devtank-ltd/prevail-ny_ventilator_interface_board/README.md

# prevail-ny_ventilator_interface_board
Interface board for PREVAIL-NY emergency ventilator
