devtank-ltd/prevail-ny_ventilator_interface_board/Ventilator_Interface_Board_RevA_BOM.xlsx

Title | PREVAIL-NY Emergency Ventilator Interface Board
Revision | A
Date | 2020-04-20
Generated | Tue 21 Apr 2020 09:53:51 BST
Company
Comment 1
Comment 2
Comment 3
Comment 4
Total Parts | 59
Total Unique Parts | 19
Ref | Qty | Value | Footprint | Manufacturer | Manufacturer Part Number | Supplier | Supplier Part number
C2 C3 C4 C5 C6 | 5 | 100nF | Capacitor_SMD:C_0603_1608Metric | Kemet | C0603C104M4RACTU | Digikey | 399-1099-1-ND
C1 C7 | 2 | 1uF | Capacitor_SMD:C_0603_1608Metric | Yageo | CC0603KRX7R7BB105 | Digikey | 311-1446-1-ND
C8 | 1 | 470pF | Capacitor_SMD:C_0603_1608Metric | Murata | GRM0335C1E471JA01D | Digikey | 490-16370-1-ND
C9 | 1 | DNF | Capacitor_SMD:C_0603_1608Metric
J1 J2 J3 J4 | 4 | Conn_01x08 | Ventilator:PhoenixContact_PTSA_1 | Phoenix Contact | 1985250 | Digikey | 277-1628-ND
P1 | 1 | Power | Socket_Arduino_Uno:Socket_Strip_Arduino_1x08 | Adafruit Industries | 85 | Digikey | 1528-1074-ND
P2 | 1 | Analog | Socket_Arduino_Uno:Socket_Strip_Arduino_1x06 | Adafruit Industries | 85 | Digikey | 1528-1074-ND | Only one kit required per board
P5 P6 P7 P8 | 4 | CONN_01X01 | Socket_Arduino_Uno:Arduino_1pin
P4 | 1 | Digital | Socket_Arduino_Uno:Socket_Strip_Arduino_1x08 | Adafruit Industries | 85 | Digikey | 1528-1074-ND
P3 | 1 | Digital | Socket_Arduino_Uno:Socket_Strip_Arduino_1x10 | Adafruit Industries | 85 | Digikey | 1528-1074-ND
R5 R4 R6 | 3 | 470R | Resistor_SMD:R_0603_1608Metric | Yageo | RC0603FR-07470RL | Digikey | 311-470HRCT-ND
R8 R10 R1 | 3 | 330R | Resistor_SMD:R_0603_1608Metric | Yageo | RC0603FR-07330RL | Digikey | 311-330HRCT-ND
R2 R9 R11 | 3 | 10K | Resistor_SMD:R_0603_1608Metric | Yageo | RC0603FR-0710KL | Digikey | 311-10.0KHRCT-ND
R3 R12 R13 | 3 | DNF | Resistor_SMD:R_0603_1608Metric
R7 R14 | 2 | 0R | Resistor_SMD:R_0603_1608Metric | Yageo | RC0603JR-070RL | Digikey | 311-0.0GRCT-ND
SW1 | 1 | SW_Push | Button_Switch_SMD:SW_SPST_B3U-1000P | Omron | B3U-1000P | Digikey | SW1020CT-ND
TP7 TP1 TP2 TP3 TP4 TP5 TP6 TP8 TP9 TP10 TP11 TP12 TP13 TP14 TP15 TP16 TP17 TP18 TP19 TP20 TP21 | 21 | TestPoint | TestPoint:TestPoint_THTPad_D1.0mm_Drill0.5mm
U1 | 1 | MP3V5004GP | Ventilator:SOP_16.8x7.62mm_P2.54mm | NXP | MP35004GP | Digikey | MP3V5004GP-ND
U2 | 1 | PSI-G-XX-MINI | DNF
Green | Can use equivalent/better
Black | Do not replace/substitute
DNP/DNF | do not populate / do not fit
