devtank-ltd/prevail-ny_ventilator_interface_board/Ventilator_Interface_Board_RevA.pdf

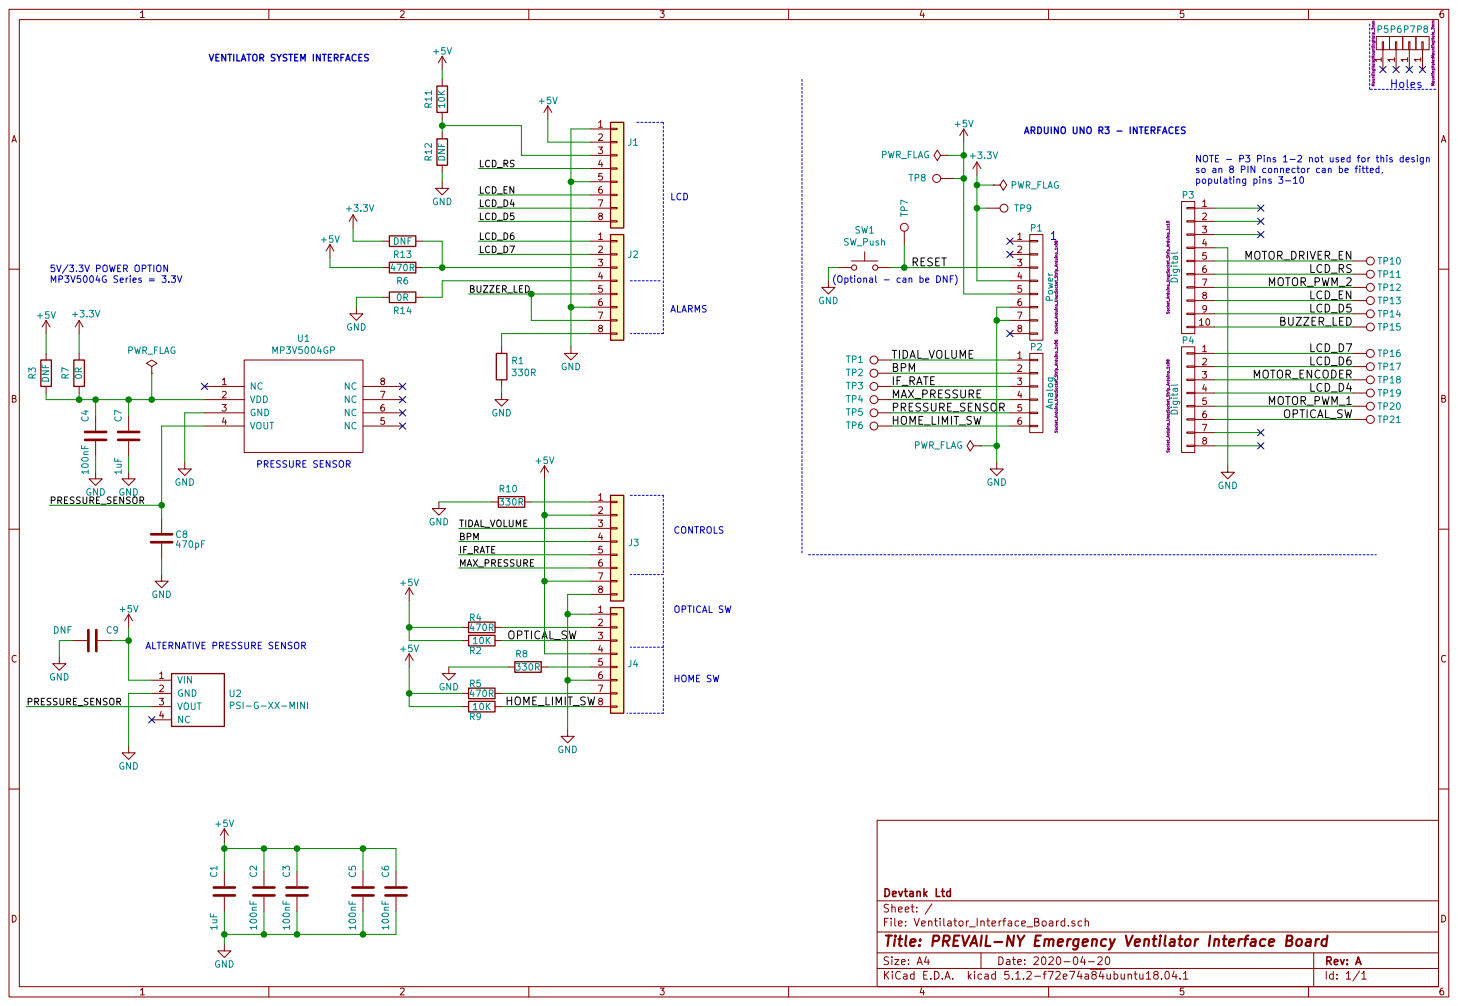
[picture p1: page 1]

IF_RATE | 3

File: Ventilator_Interface_Board.sch Sheet: / Devtank Ltd

Id: 1/1 Title: PREVAIL-NY Emergency Ventilator Interface Board
