devtank-ltd/prevail-ny_ventilator_interface_board/Ventilator_Interface_Board.kicad_pcb

## KiCad design Ventilator_Interface_Board.kicad_pcb (2020-04-20)

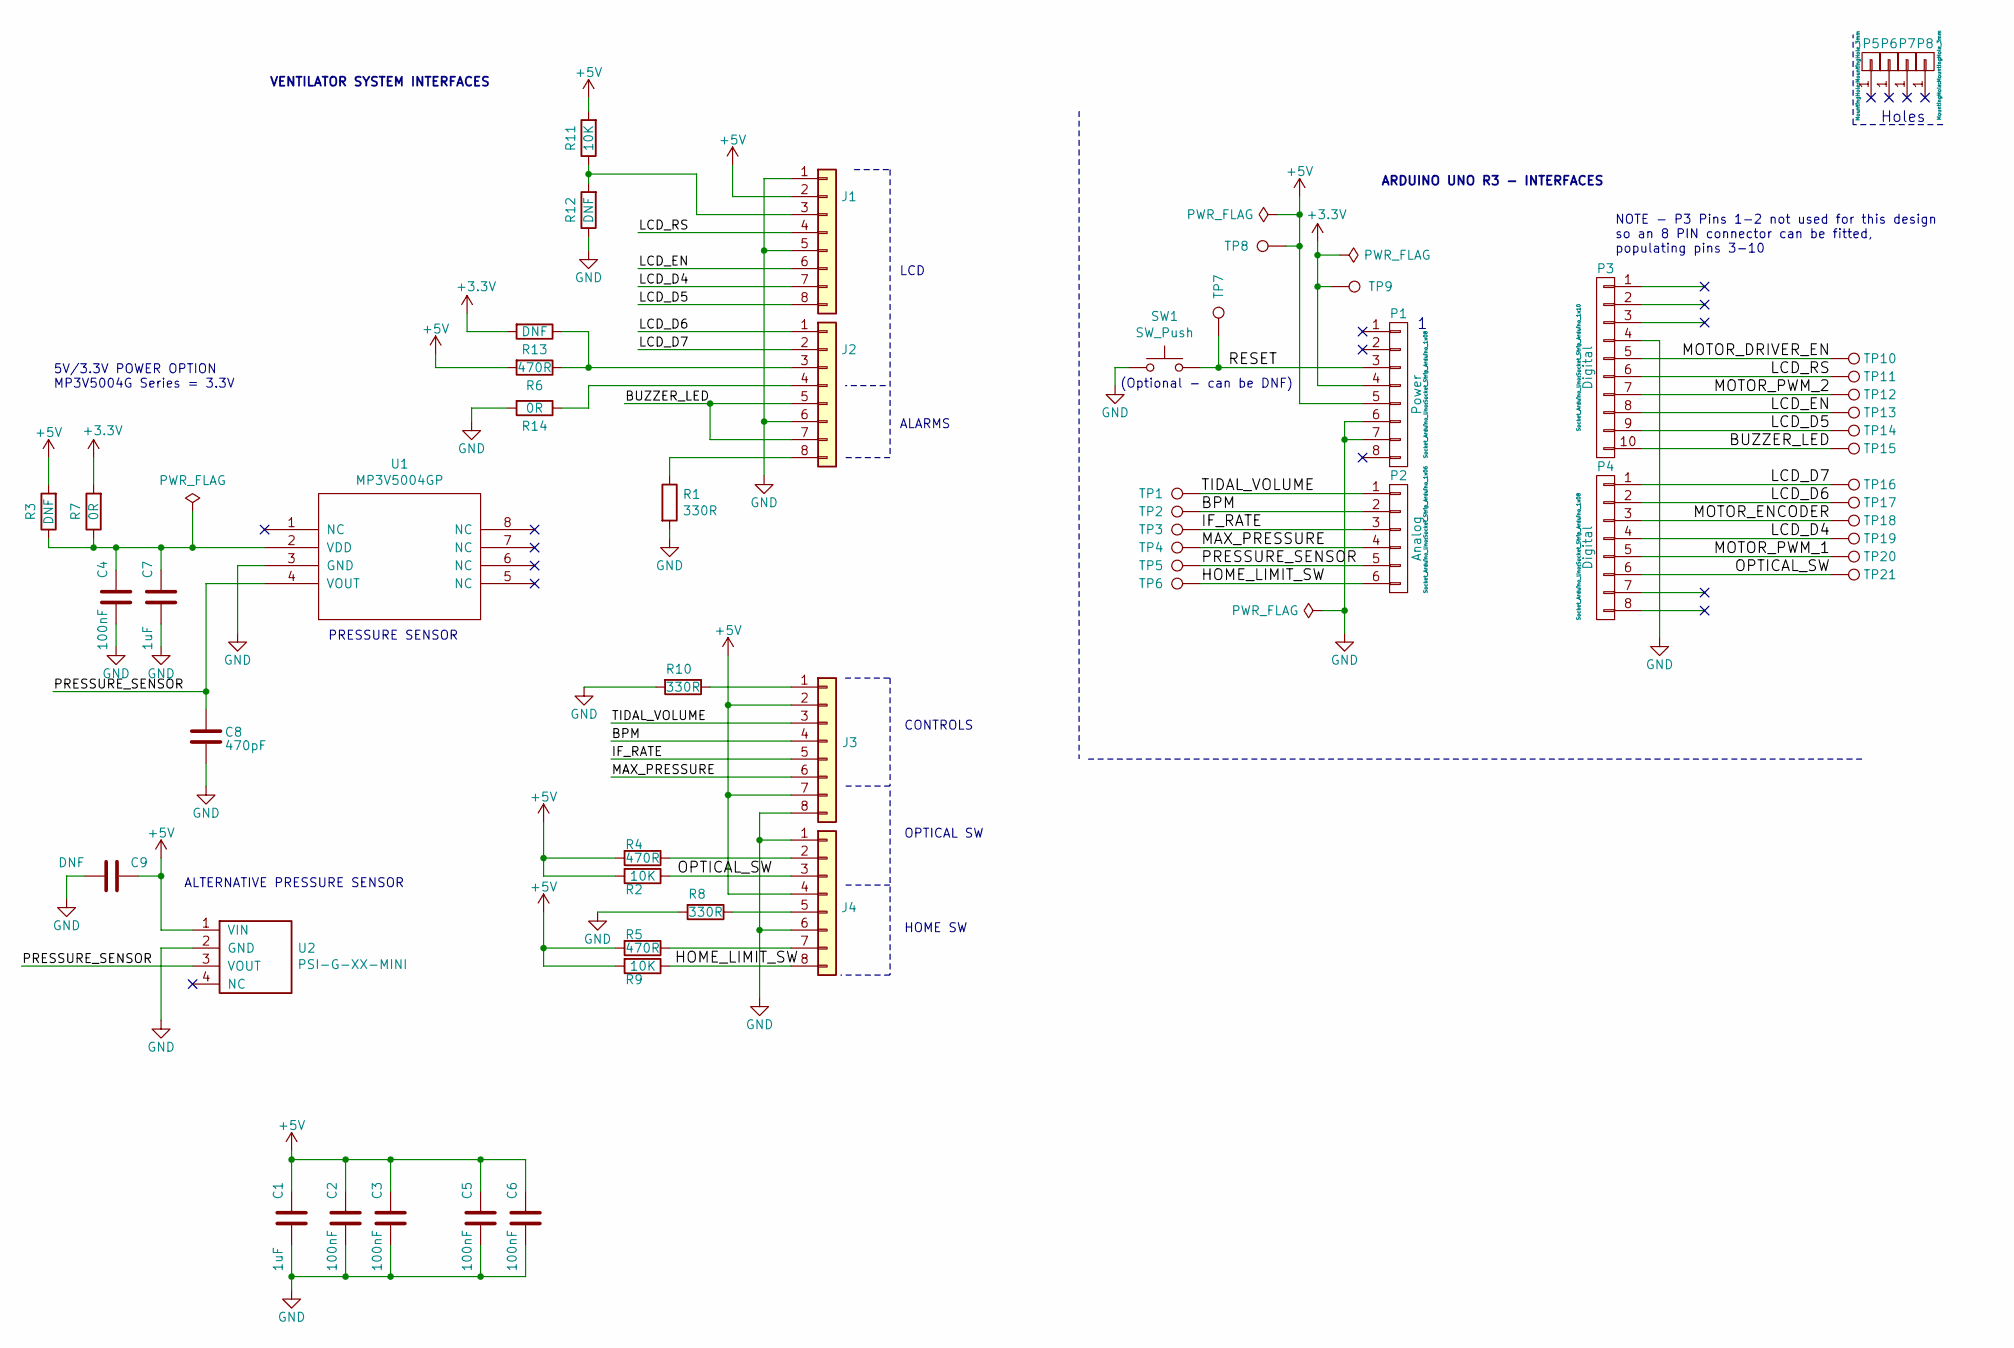
[picture p2: schematic Ventilator_Interface_Board.sch, PREVAIL-NY Emergency Ventilator Interface Board]

Parts:
C1, C7: 1uF; C_0603_1608Metric
C2, C3, C4, C5, C6: 100nF; C_0603_1608Metric
C8: 470pF; C_0603_1608Metric
C9: DNF; C_0603_1608Metric
J1, J2, J3, J4: Conn_01x08; PhoenixContact_PTSA_1,5_8-3_5-Z_1x08_P3.50mm_Vertical
P1: Power; Socket_Strip_Arduino_1x08
P2: Analog; Socket_Strip_Arduino_1x06
P3: Digital; Socket_Strip_Arduino_1x10
P4: Digital; Socket_Strip_Arduino_1x08
P5, P6, P7, P8: CONN_01X01; MountingHole_3mm
R1, R8, R10: 330R; R_0603_1608Metric
R2, R9, R11: 10K; R_0603_1608Metric
R3, R12, R13: DNF; R_0603_1608Metric
R4, R5, R6: 470R; R_0603_1608Metric
R7, R14: 0R; R_0603_1608Metric
SW1: SW_Push; SW_SPST_B3U-1000P
TP1, TP2, TP3, TP4, TP5, TP6, TP7, TP8, TP9, TP10, TP11, TP12, TP13, TP14, TP15, TP16, TP17, TP18, TP19, TP20, TP21: TestPoint; TestPoint_THTPad_D1.0mm_Drill0.5mm
U1: MP3V5004GP; SOP_16.8x7.62mm_P2.54mm
U2: PSI-G-XX-MINI; PinHeader_1x04_P2.54mm_Vertical

Connections:
+3V3: P1.4, R7.2, R13.2, TP9.1
+5V: C1.2, C2.2, C3.2, C5.2, C6.2, C9.2, J1.2, J3.2, J3.7, J4.4, P1.5, R2.2, R3.2, R4.2, R5.2, R6.2, R9.2, R11.2, TP8.1, U2.1 (VIN)
/BPM: J3.4, P2.2, TP2.1
/BUZZER_LED: J2.5, J2.7, P3.10, TP15.1
/HOME_LIMIT_SW: J4.8, P2.6, R9.1, TP6.1
/IF_RATE: J3.5, P2.3, TP3.1
/LCD_D4: J1.7, P4.4, TP19.1
/LCD_D5: J1.8, P3.9, TP14.1
/LCD_D6: J2.1, P4.2, TP17.1
/LCD_D7: J2.2, P4.1, TP16.1
/LCD_EN: J1.6, P3.8, TP13.1
/LCD_RS: J1.4, P3.6, TP11.1
/MAX_PRESSURE: J3.6, P2.4, TP4.1
/MOTOR_DRIVER_EN: P3.5, TP10.1
/MOTOR_ENCODER: P4.3, TP18.1
/MOTOR_PWM_1: P4.5, TP20.1
/MOTOR_PWM_2: P3.7, TP12.1
/OPTICAL_SW: J4.3, P4.6, R2.1, TP21.1
/PRESSURE_SENSOR: C8.2, P2.5, TP5.1, U1.4 (VOUT), U2.3 (VOUT)
/RESET: P1.3, SW1.2, TP7.1
/TIDAL_VOLUME: J3.3, P2.1, TP1.1
GND: C1.1, C2.1, C3.1, C4.1, C5.1, C6.1, C7.1, C8.1, C9.1, J1.1, J1.5, J2.6, J3.8, J4.1, J4.6, P1.6, P1.7, P3.4, R1.2, R8.2, R10.2, R12.1, R14.2, SW1.1, U1.3 (GND), U2.2 (GND)
unnamed: C4.2, C7.2, R3.1, R7.1, U1.2 (VDD)
unnamed: J1.3, R11.1, R12.2
unnamed: J2.3, R6.1, R13.1
unnamed: J2.4, R14.1
unnamed: J2.8, R1.1
unnamed: J3.1, R10.1
unnamed: J4.2, R4.1
unnamed: J4.5, R8.1
unnamed: J4.7, R5.1

Notes on the sheet:
Holes
ARDUINO UNO R3 - INTERFACES
VENTILATOR SYSTEM INTERFACES
NOTE - P3 Pins 1-2 not used for this design so an 8 PIN connector can be fitted, populating pins 3-10
5V/3.3V POWER OPTION MP3V5004G Series = 3.3V
LCD
(Optional - can be DNF)
ALARMS
CONTROLS
OPTICAL SW
HOME SW
ALTERNATIVE PRESSURE SENSOR
PRESSURE SENSOR

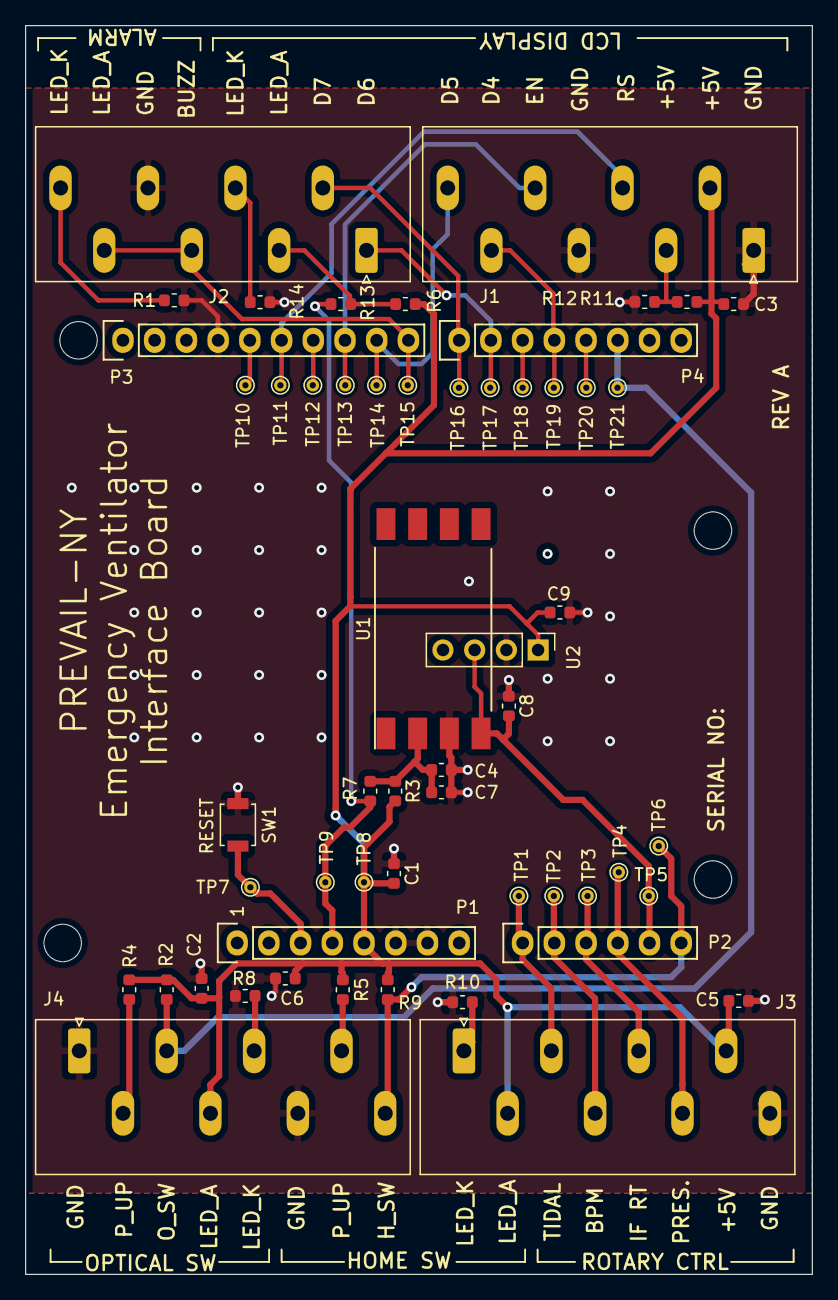
[picture p3: board Ventilator_Interface_Board.kicad_pcb from above]

Board: 2 copper layers, 63.0 x 100.0 mm, 59 parts (0 on the bottom side), 31 nets.
