devtank-ltd/prevail-ny_ventilator_interface_board/(commit log)

2020-04-09 added project files
    [Ventilator_Interface_Board-2020-04-08-21-59-16.sch, Ventilator_Interface_Board.kicad_pcb, Ventilator_Interface_Board.sch, Ventilator_Interface_Board_RevA_BOM.xlsx]
2020-04-17 Rev A - pre-release
    [Ventilator_Interface_Board.csv, Ventilator_Interface_Board.kicad_pcb, Ventilator_Interface_Board.sch]
2020-04-20 minor changes to make design more flexible
    [Ventilator_Interface_Board.kicad_pcb, Ventilator_Interface_Board.sch, Ventilator_Interface_Board_RevA_BOM.xlsx]
2020-04-21 Rev A released
    [Ventilator_Interface_Board.csv, Ventilator_Interface_Board_RevA_BOM.xlsx]
